mostafaaabedia-tech/Defense-System_ESP32/oled-screens.png

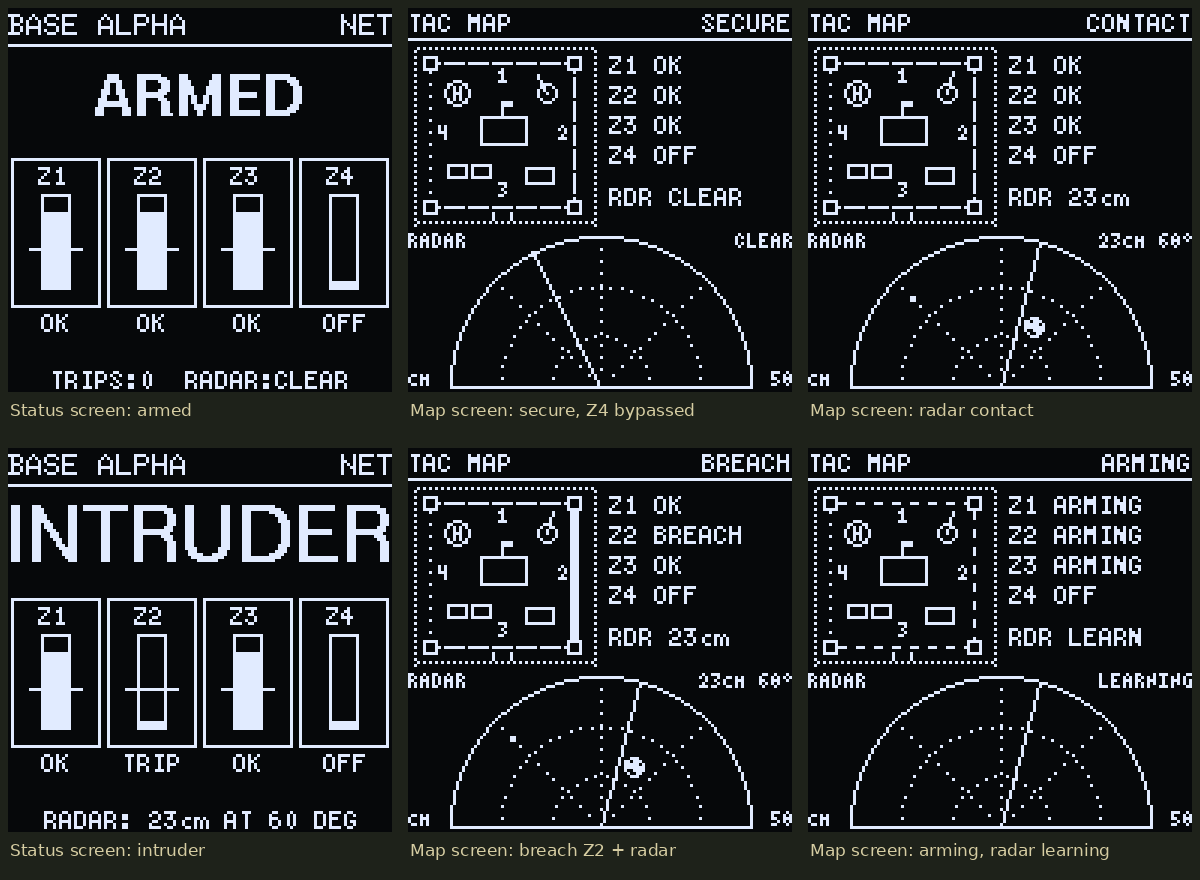
oled-screens.png
