mostafaaabedia-tech/Defense-System_ESP32/(commit log)

2026-10-24 Add radar, SH1107 map screen, ESP32 firmware and wiring guide
    - Website: radar scope panel, radar contact alerts, radar drill,
    updated online timing (15 min reports)
    - Firmware: 4 laser tripwires, latched siren + reset, servo + HC-SR04
    radar with learned background, second SH1107 screen with tactical
    map and radar scope, ntfy.sh alerts
    - README with full wiring and setup, OLED screen previews
    Claude-Session: https://claude.ai/code/session_01TvNhELDBeL9GC3jJcKLcHU
    [base_alarm.ino]
2026-10-25 Fix SH1107 screen showing random dots
    The firmware defaulted to the SSD1327 chip, so an SH1107 got the wrong
    start-up commands and showed noise. SH1107 is now the default, screens
    are found automatically on pins 21/22 and 16/17 (one screen switches
    pages, two screens split status and map), the I2C address (0x3C/0x3D)
    is detected, a "SCREEN OK" page shows at power on, and Serial prints
    which screens were found.
    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
    [base_alarm.ino]
2026-10-25 Fix SH1107 picture shifted 32 pixels on GME128128-01-IIC
    U8g2's generic SH1107 128x128 driver adds a 96-column offset, which
    wraps the picture on GME128128-01-IIC boards (zones read Z2 Z3 Z4 Z1).
    The no-offset driver is now SH1107_VARIANT 1 (default); the old one is 2.
    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
    [base_alarm.ino]
2026-10-26 Add floodlight relay that turns on when an intruder is detected
    Relay on GPIO 19 switches on with the alarm and off when the guard
    presses reset (option to also switch on during a radar contact).
    Works with active-low 5 V relay modules by releasing the pin for "off".
    The website shows the floodlight state and lights up the tactical map.
    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
    [base_alarm.ino]
2026-10-26 README: floodlight relay wiring and safety
    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
2026-10-26 Relay: default to high-level trigger, add no-click troubleshooting
    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
